connorwhite-online/junkr-obd/hardware/3d_models/ATTRIBUTION.md

# Third-Party 3D Model Attribution

## Adafruit_CAD_Parts (MIT License)

The following STEP files are vendored from Adafruit's public CAD parts
repository, used under the MIT License.

- `ads1115_pid1085.step` — Adafruit ADS1115 breakout (PID 1085)
- `qualia_esp32s3_pid5800.step` — Adafruit Qualia ESP32-S3 (PID 5800)

Source: https://github.com/adafruit/Adafruit_CAD_Parts
Copyright (c) 2016 Adafruit Industries. MIT License.

```
Permission is hereby granted, free of charge, to any person obtaining a copy
of this software and associated documentation files (the "Software"), to deal
in the Software without restriction, including without limitation the rights
to use, copy, modify, merge, publish, distribute, sublicense, and/or sell
copies of the Software, and to permit persons to whom the Software is
furnished to do so, subject to the following conditions:

The above copyright notice and this permission notice shall be included in all
copies or substantial portions of the Software.

THE SOFTWARE IS PROVIDED "AS IS", WITHOUT WARRANTY OF ANY KIND...
```

Full license text: https://github.com/adafruit/Adafruit_CAD_Parts/blob/main/LICENSE

> Other models referenced in [`../docs/3D_MODELS.md`](../docs/3D_MODELS.md)
> (TE Connectivity, McMaster-Carr, manufacturer-supplied) are **not**
> vendored here — their terms of use prohibit redistribution. Download
> them directly from the source per the instructions in that doc.
