connorwhite-online/junkr-obd/hardware/ecu_interposer/diagram/connector_diagram.pdf

## 1 Exploded view (mating axis left to right)

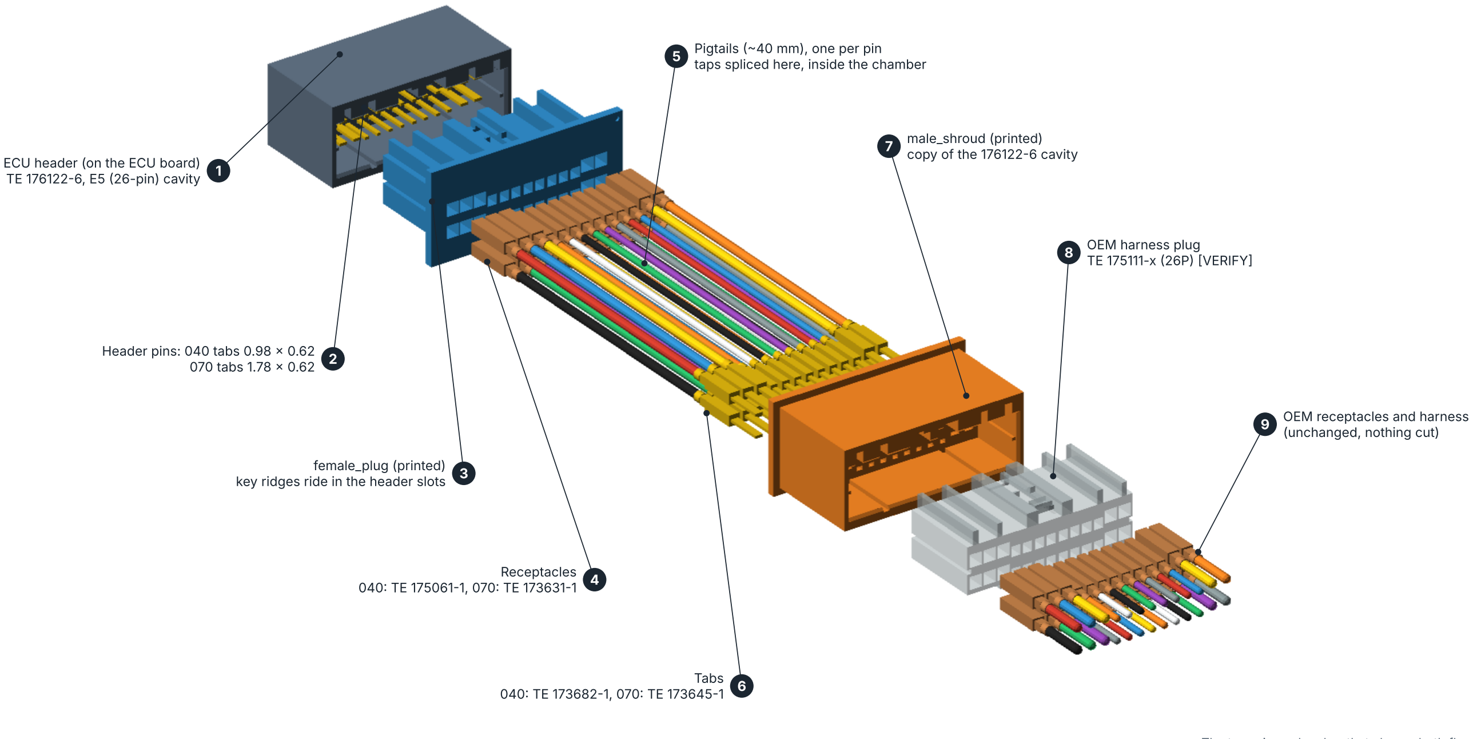
[picture p3: figure]
1 ECU header (on the ECU board) TE 176122-6, E5 (26-pin) cavity; 2 Header pins: 040 tabs 0.98 x 0.62 070 tabs 1.78 x 0.62; 3 female_plug (printed) key ridges ride in the header slots; 4 Receptacles 040: TE 175061-1, 070: TE 173631-1; 5 Pigtails (~40 mm), one per pin; taps spliced here, inside the chamber; 6 Tabs 040: TE 173682-1, 070: TE 173645-1; 7 male_shroud (printed) copy of the 176122-6 cavity; OEM harness plug TE 175111-x (26P) [VERIFY]; OEM receptacles and harness (unchanged, nothing cut)

2 Section A-A: interposer plug seated in the ECU header, cut 4 mm above the floor (pin numbers from the KZJ95 manual)
Fit in the header

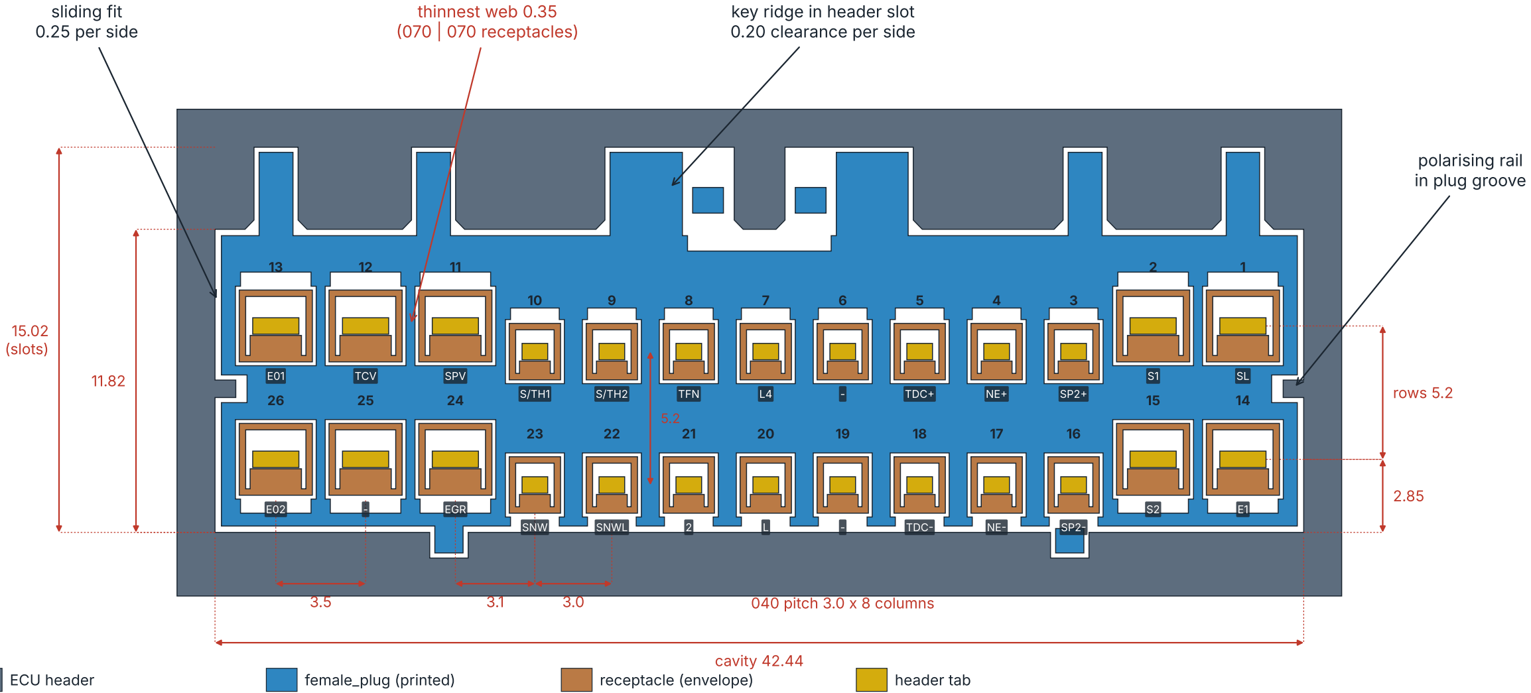
[picture p4: figure]
cavity 42.44; 040 pitch 3.0 x 8 columns; rows 5.2; 15.02 (slots); thinnest web 0.35 (070 | 070 receptacles); key ridge in header slot 0.20 clearance per side; polarising rail in plug groove; sliding fit 0.25 per side; ECU header; female_plug (printed); receptacle (envelope); header tab; TCV; SPV; EGR; SNW; SNWL; TFN; TDC+; TDC-

Plug envelope vs cavity | 41.94 x 11.32 in 42.44 x 11.82 (0.25/side)
Key ridges vs slots | 0.20/side, unique pattern per section
Insertion depth | 14.3 of 14.5 (stops 0.2 short of the floor)

Pin engagement

040 tab into receptacle | 5.89 (tab 7.09 proud - gap 0.2 - face wall 1.0)
070 tab into receptacle | 6.79 (tab 7.99 proud)
Shroud side | identical by construction (same tab heights)

Walls in the printed plug

Between columns | 070 | 070: 0.35 070 | 040: 0.37 040 | 040: 0.70
Between rows | 040: 2.70 070: 2.10
Under lower row (incl. lance) | 040: -0.10 070: +0.50
Over upper row (incl. lance) | 040: 2.82 070: 1.42

Verdict

Fits and engages as designed. Walls under 0.6 mm need resin or MJF.

Lower 040 lance reliefs break 0.1 mm through the underside: they

become open windows, which is harmless but visible.

Latch from TE's 175110-6 STEP. Still [MEASURE]: terminal body sizes.

## Analysis

070 column: pins 13 / 26 (E01 / E02)

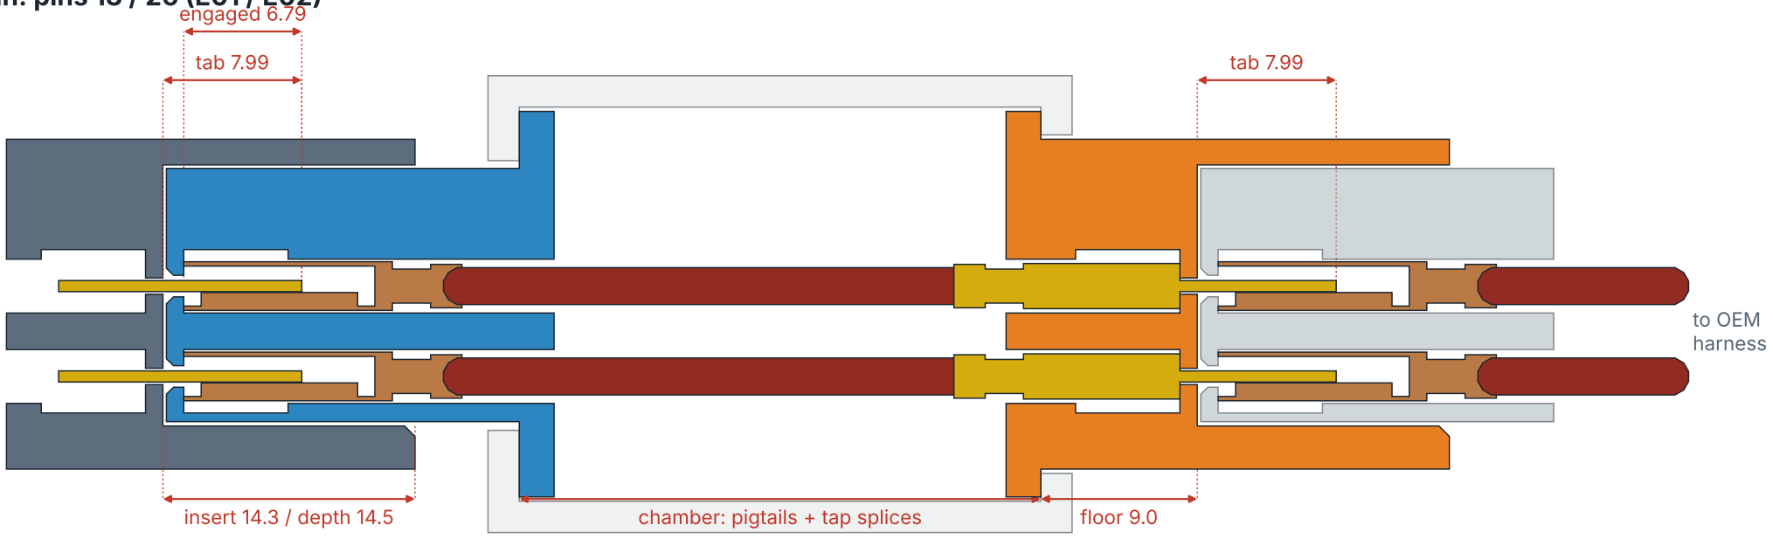
[picture p5: figure]
tab 7.99; engaged 6.79; insert 14.3 / depth 14.5; chamber: pigtails + tap splices; floor 9.0; to OEM harness

ECU
board

3 Section B-B: lengthwise through one pin column, assembled (ECU on the left, harness on the right)

040 column: pins 9 / 22 (S/TH2 / SNWL)

ECU
board

# 1KZ-TE ECU interposer: E5 (26-pin) section, exploded view and cross-section analysis

Header TE 176122-6 (geometry measured from TE's 3D model). Terminal bodies are estimates [MEASURE]; the latch is from TE's 175110-6 model. All dimensions in mm.

The two-piece chamber that clamps both flanges is hidden here; it is shown in section 3.

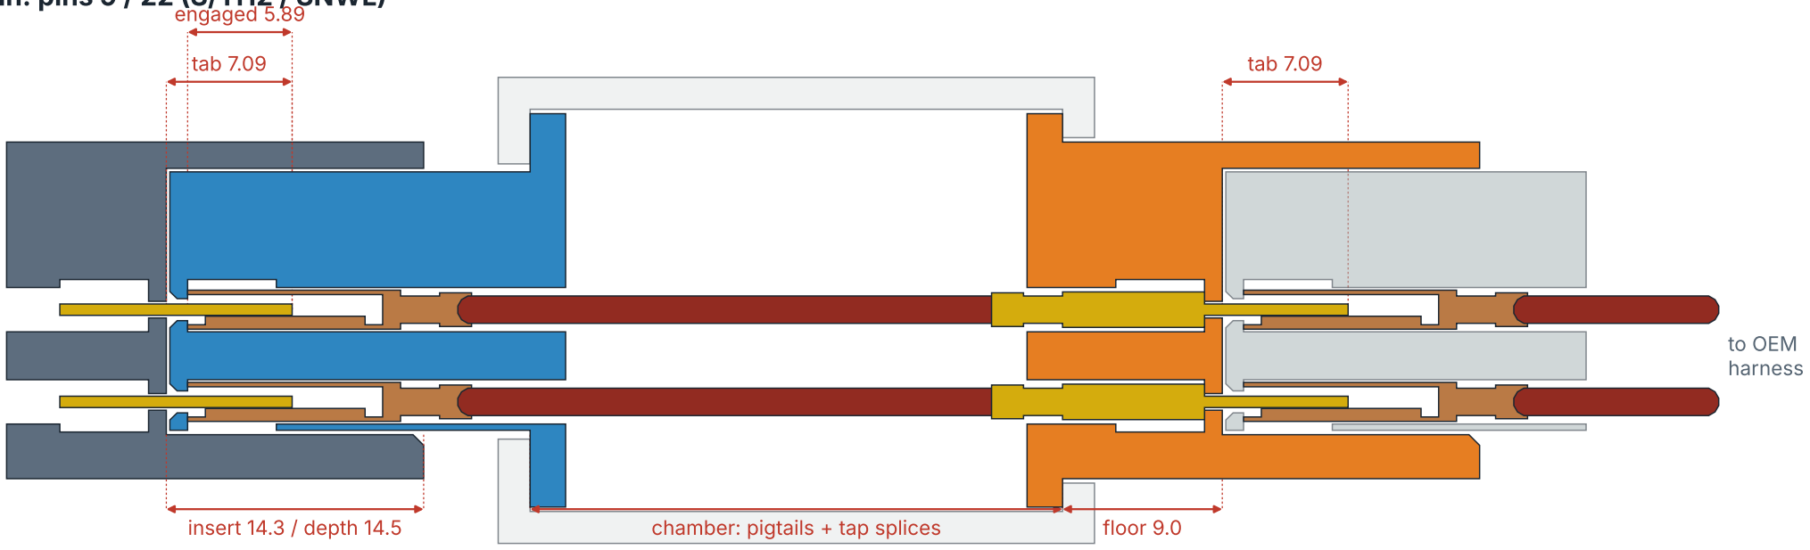
[picture p6: figure]
tab 7.09; engaged 5.89; insert 14.3 / depth 14.5; chamber: pigtails + tap splices; floor 9.0; to OEM harness

Generated by hardware/ecu_interposer/diagram/make_diagram.py from cad/diagram.scad. Sections are true scale.
