connorwhite-online/junkr-obd/docs/gauge/firmware/02_temps.png

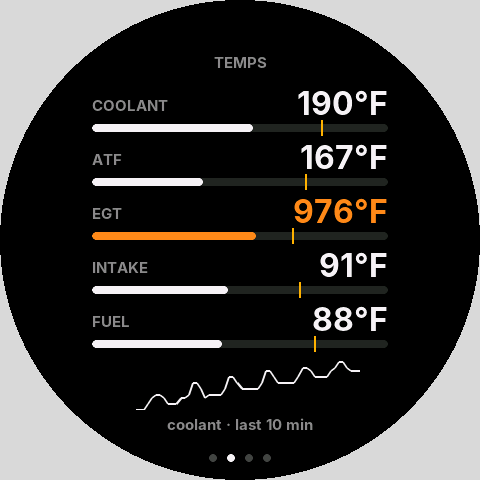
docs/gauge/firmware/02_temps.png
