connorwhite-online/junkr-obd/docs/gauge/firmware/03_engine.png

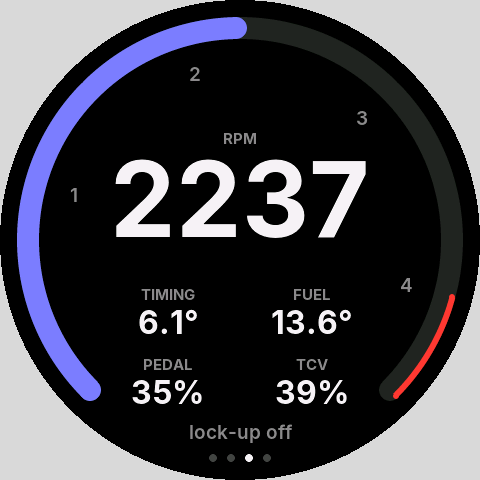
docs/gauge/firmware/03_engine.png
