connorwhite-online/junkr-obd/docs/gauge/firmware/05_alert.png

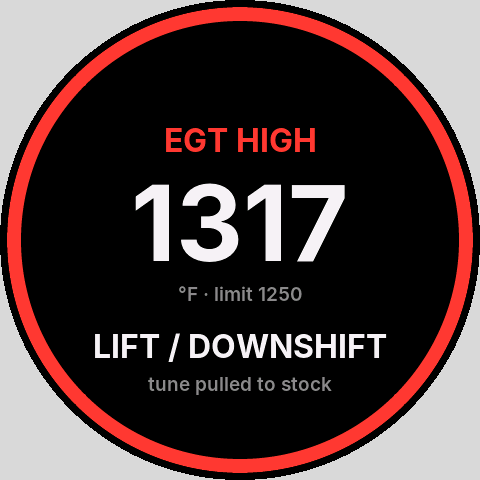
docs/gauge/firmware/05_alert.png
