connorwhite-online/junkr-obd/hardware/ecu_interposer/diagram/connector_diagram.png

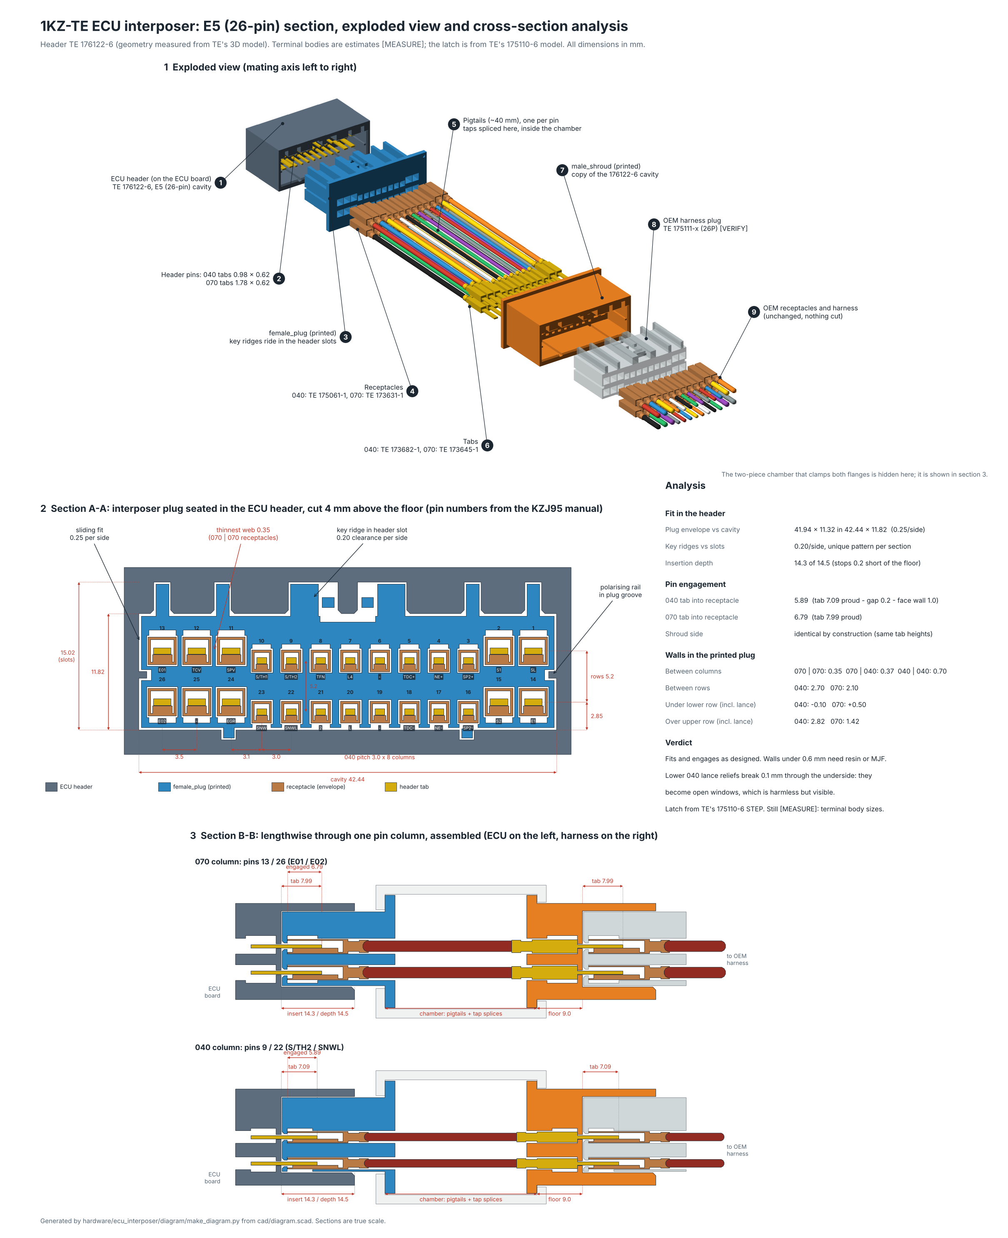
hardware/ecu_interposer/diagram/connector_diagram.png
