connorwhite-online/junkr-obd/hardware/3d_models/ads1115_pid1085.step

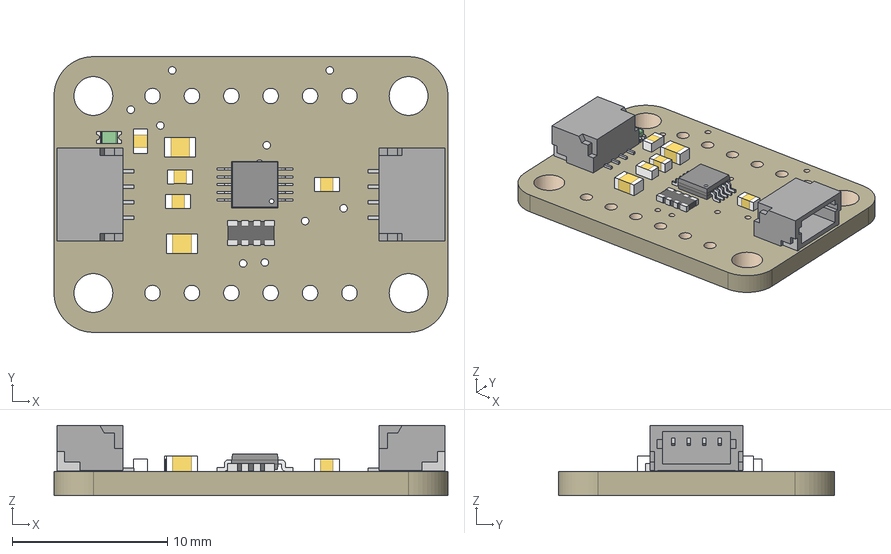
[picture p11: CAD file, 2026-05-25]
hardware/3d_models/ads1115_pid1085.step
25.4 x 17.8 x 4.53 mm
Board
ADS1015IDGST
10uF x 2
10K x 4
STEMMA_I2C_QT x 2
GREEN
10K_1
