connorwhite-online/junkr-obd/hardware/ecu_interposer/stl/tapbox_min_lid.stl

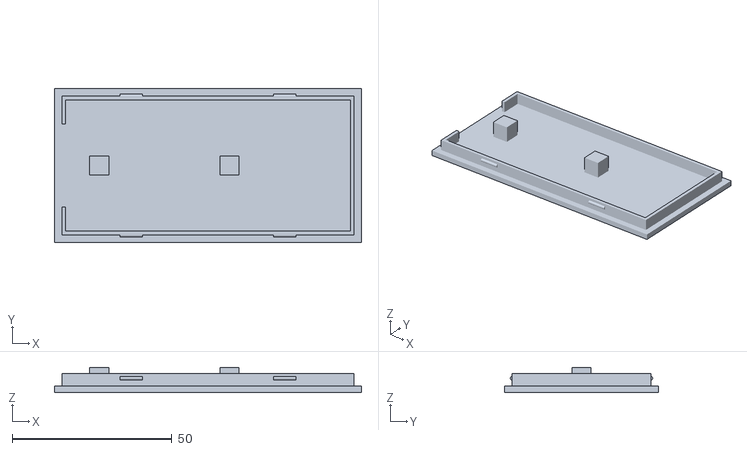
[picture p12: CAD file, 2026-11-11]
hardware/ecu_interposer/stl/tapbox_min_lid.stl
96.0 x 48.0 x 7.90
