connorwhite-online/junkr-obd/hardware/ecu_interposer/stl/tapbox_min_base.stl

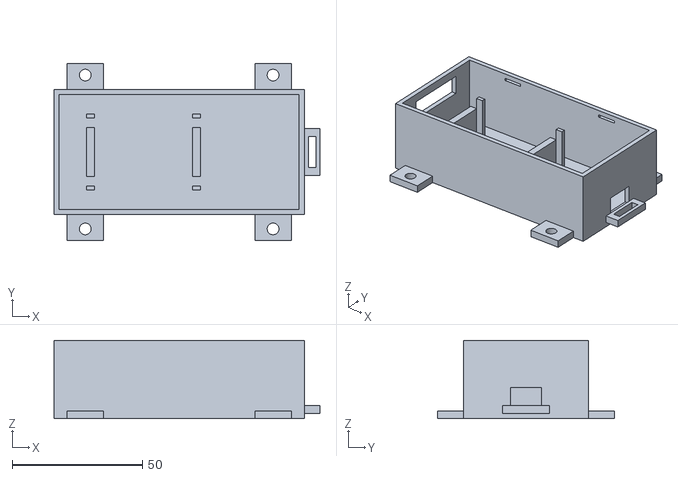
[picture p13: CAD file, 2026-11-11]
hardware/ecu_interposer/stl/tapbox_min_base.stl
102.0 x 68.0 x 30.0
