connorwhite-online/junkr-obd/hardware/ecu_interposer/stl/E5_26P_female_plug_fittest_no_latch.stl

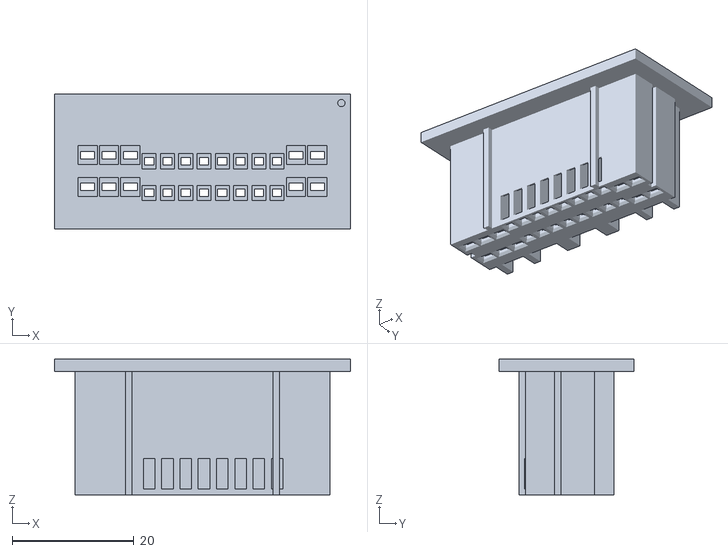
[picture p15: CAD file, 2026-10-23]
hardware/ecu_interposer/stl/E5_26P_female_plug_fittest_no_latch.stl
48.6 x 22.2 x 22.3
