connorwhite-online/junkr-obd/hardware/ecu_interposer/stl/E8_22P_female_plug.stl

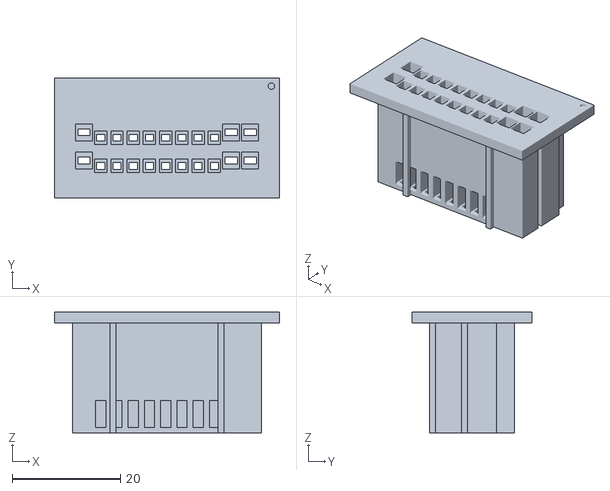
[picture p16: CAD file, 2026-10-23]
hardware/ecu_interposer/stl/E8_22P_female_plug.stl
41.6 x 22.2 x 22.3
