connorwhite-online/junkr-obd/hardware/ecu_interposer/stl/E6_16P_male_shroud.stl

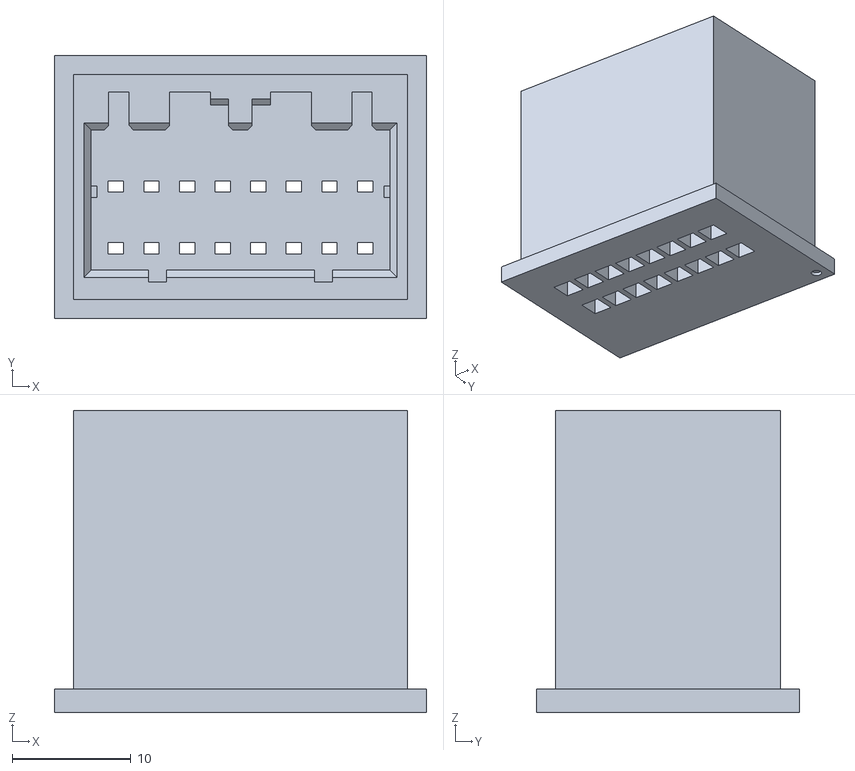
[picture p17: CAD file, 2026-10-23]
hardware/ecu_interposer/stl/E6_16P_male_shroud.stl
31.4 x 22.2 x 25.5
