connorwhite-online/junkr-obd/hardware/ecu_interposer/stl/E6_16P_female_plug.stl

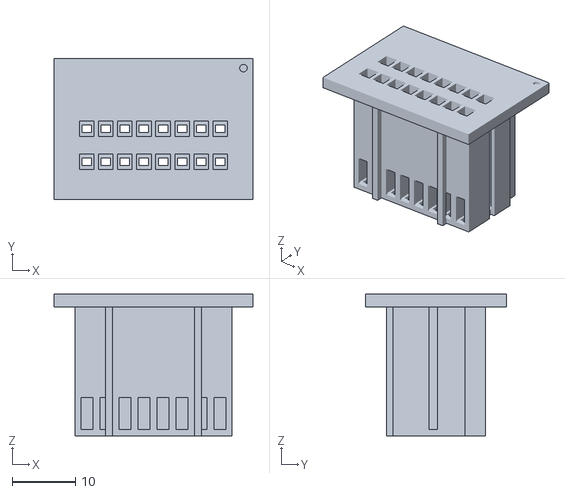
[picture p18: CAD file, 2026-10-23]
hardware/ecu_interposer/stl/E6_16P_female_plug.stl
31.4 x 22.2 x 22.3
