connorwhite-online/junkr-obd/hardware/ecu_interposer/stl/tapbox_lid.stl

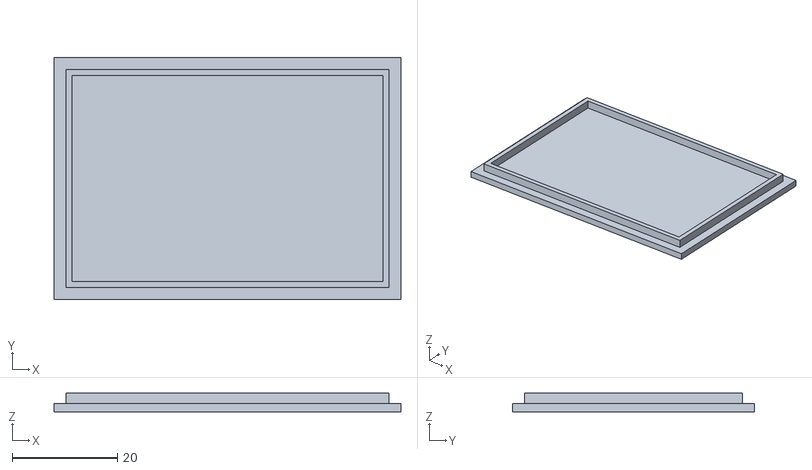
[picture p19: CAD file, 2026-10-23]
hardware/ecu_interposer/stl/tapbox_lid.stl
66.0 x 46.0 x 3.59
