connorwhite-online/junkr-obd/hardware/ecu_interposer/stl/E8_22P_male_shroud.stl

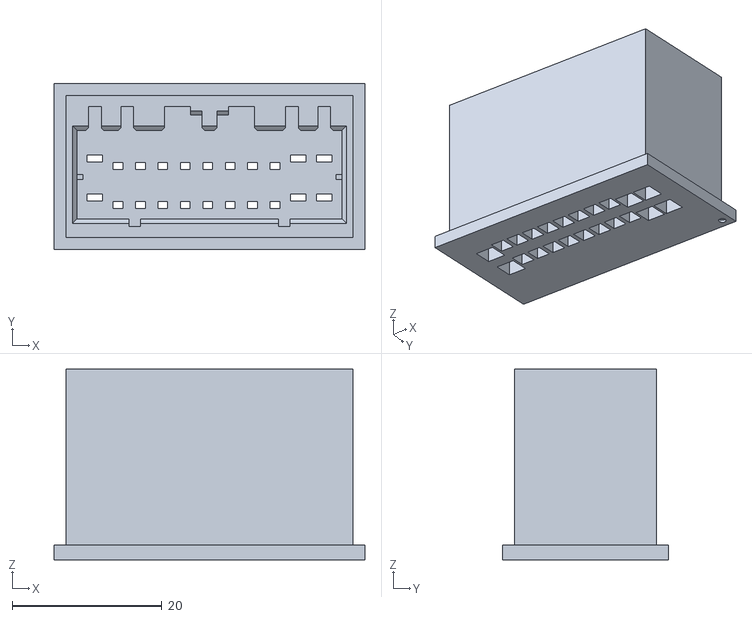
[picture p20: CAD file, 2026-10-23]
hardware/ecu_interposer/stl/E8_22P_male_shroud.stl
41.6 x 22.2 x 25.5
