connorwhite-online/junkr-obd/hardware/ecu_interposer/stl/E6_16P_chamber_top.stl

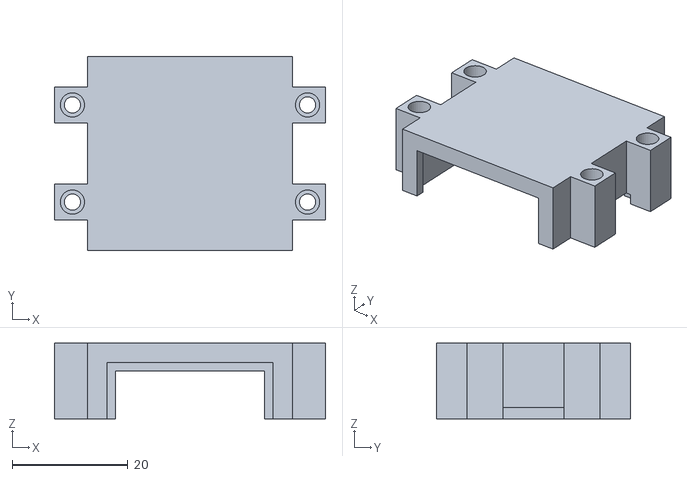
[picture p21: CAD file, 2026-10-23]
hardware/ecu_interposer/stl/E6_16P_chamber_top.stl
46.9 x 33.6 x 13.1
