connorwhite-online/junkr-obd/hardware/ecu_interposer/stl/fit_coupon.stl

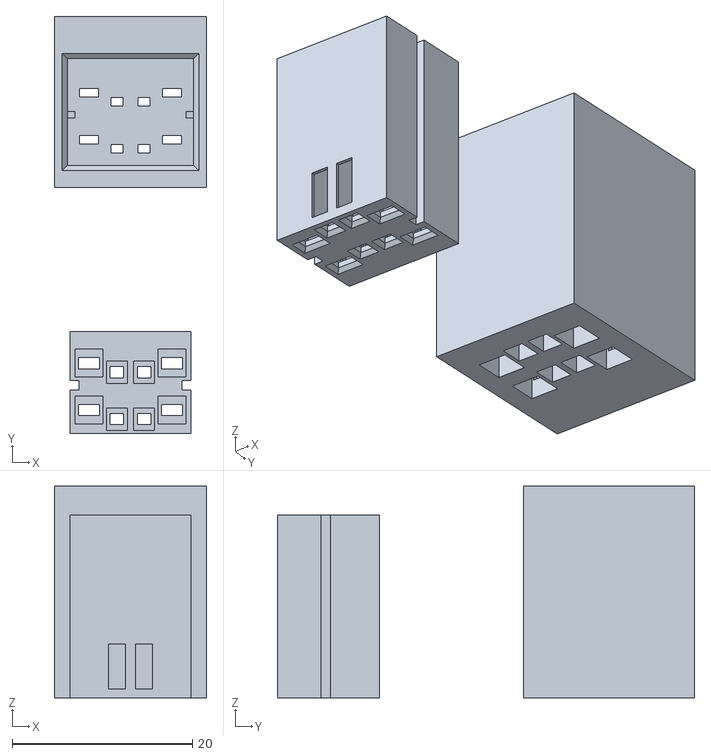
[picture p22: CAD file, 2026-10-23]
hardware/ecu_interposer/stl/fit_coupon.stl
16.9 x 46.2 x 23.5
