connorwhite-online/junkr-obd/(list of files, cad)

Other CAD files:
hardware/ecu_interposer/stl/E5_26P_female_plug.stl
