connorwhite-online/junkr-obd/docs/build-stages/renders/E6_16P_chamber_bottom.png

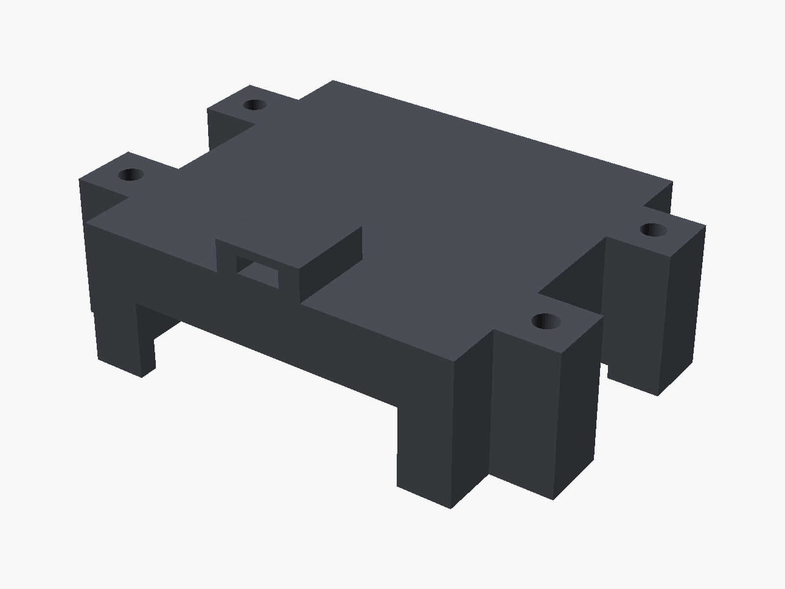
docs/build-stages/renders/E6_16P_chamber_bottom.png
