connorwhite-online/junkr-obd/docs/build-stages/renders/E6_16P_female_plug.png

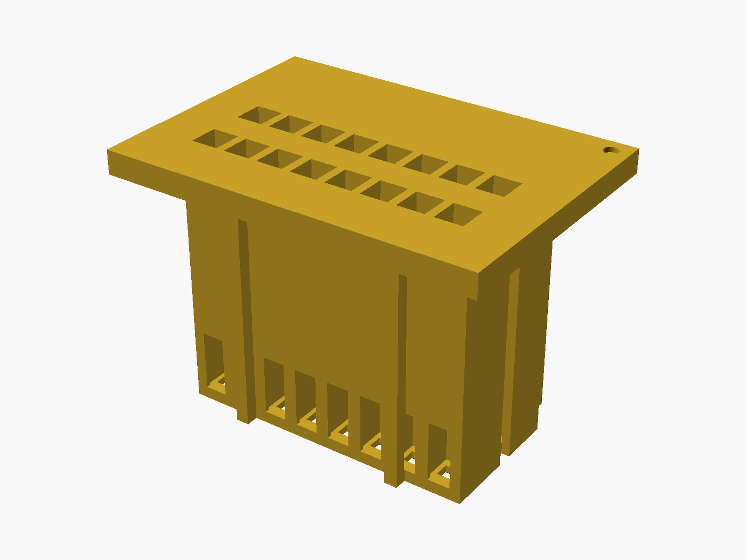
docs/build-stages/renders/E6_16P_female_plug.png
