connorwhite-online/junkr-obd/docs/build-stages/renders/E6_16P_male_shroud.png

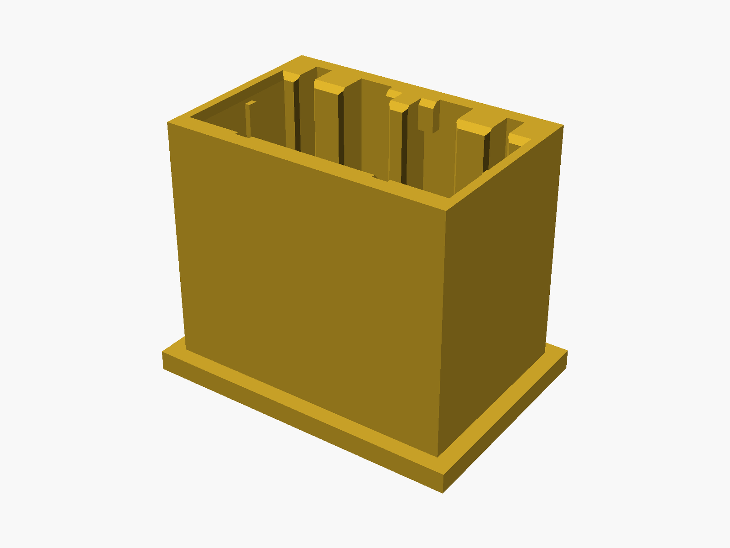
docs/build-stages/renders/E6_16P_male_shroud.png
