connorwhite-online/junkr-obd/docs/build-stages/renders/E6_exploded.png

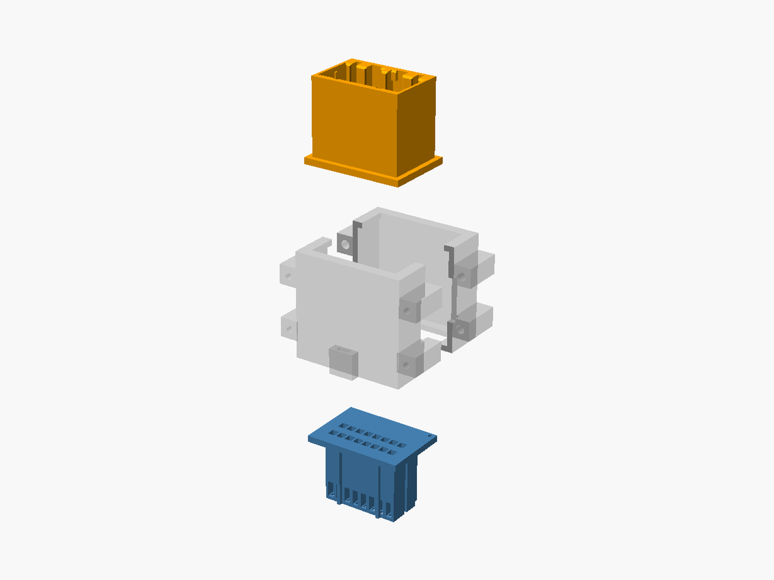
docs/build-stages/renders/E6_exploded.png
