connorwhite-online/junkr-obd/docs/build-stages/renders/E8_22P_chamber_top.png

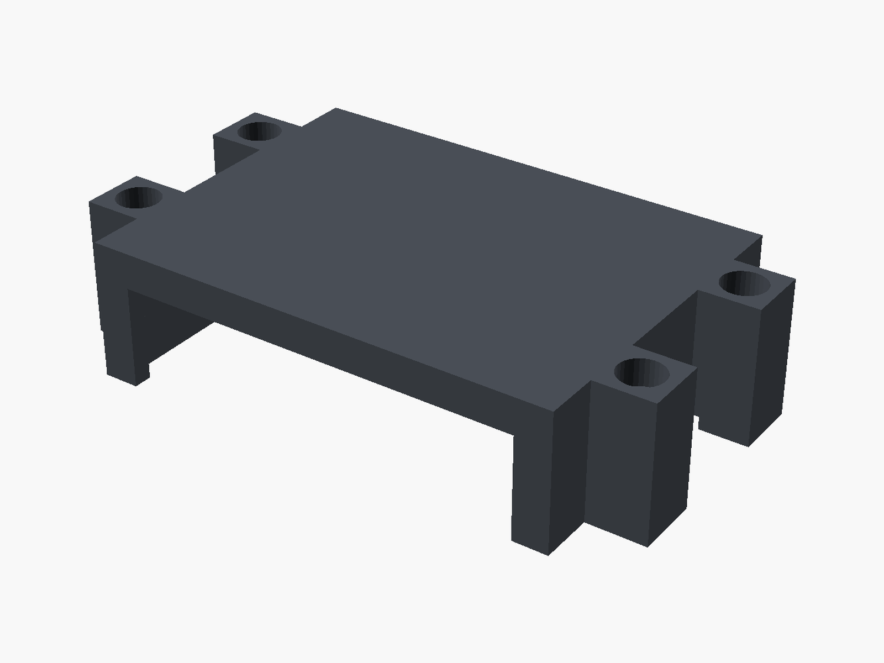
docs/build-stages/renders/E8_22P_chamber_top.png
