connorwhite-online/junkr-obd/docs/build-stages/renders/E8_22P_female_plug.png

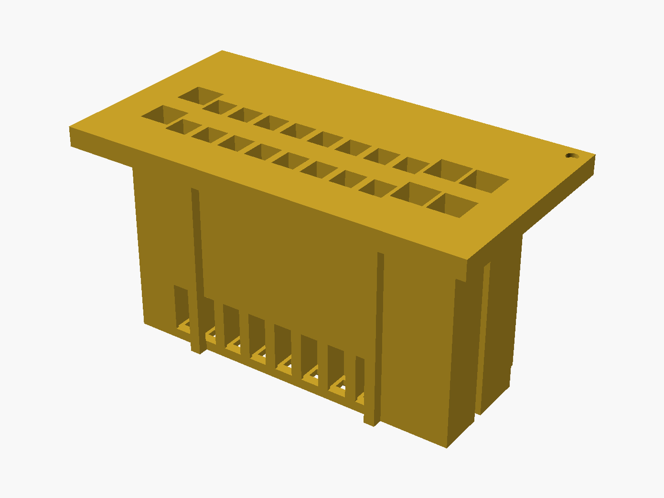
docs/build-stages/renders/E8_22P_female_plug.png
