connorwhite-online/junkr-obd/docs/build-stages/renders/E8_assembled.png

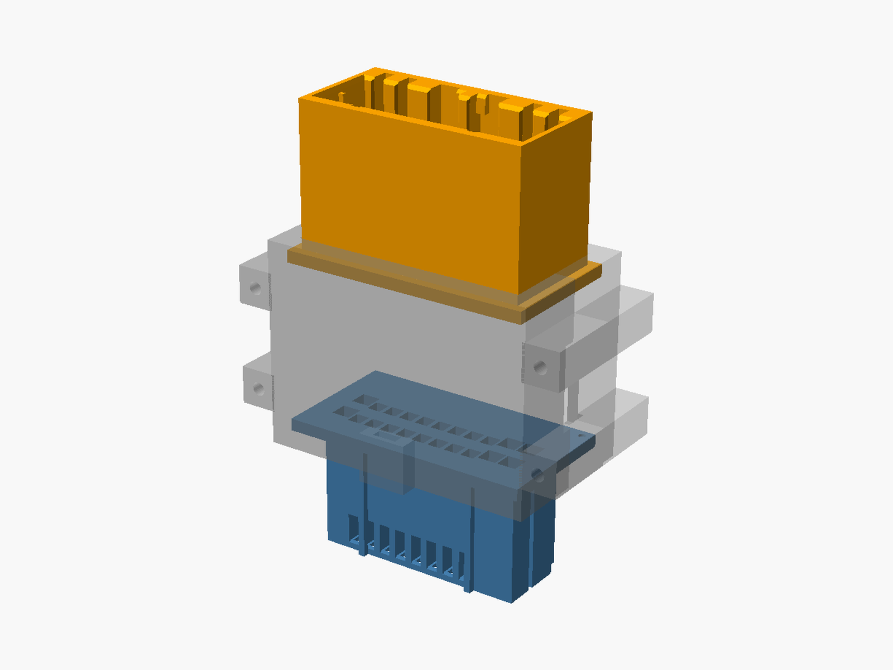
docs/build-stages/renders/E8_assembled.png
