connorwhite-online/junkr-obd/(commit log)

2025-11-07 Rescope gauge to specific engine parameters (#2)
    * Checkpoint before follow-up message
    * Refactor: Add dual IAT sensors and remove oil temp/battery voltage
    ---------
2025-11-08 Integrate display and driver for sensor value visualization (#4)
    * docs: Add guide for migrating Nextion to Adafruit TFT
    * feat: Add SquareLine Studio + LVGL display support
    This commit introduces support for SquareLine Studio and the LVGL graphics library, providing a Mac-compatible visual GUI design solution. It includes updated documentation, hardware configurations, and code examples for integrating the new display system.
    * Refactor documentation and add new guides
    * Add documentation for Adafruit 5806 displa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
2025-11-08 Update documentation for Qualia ESP32 (#5)
    * Refactor: Update docs for ESP32-S3 platform migration
    * Refactor: Update docs for platform migration
    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
2025-11-08 Consolidate sensor inputs to i2c module (#6)
    * feat: Add I2C sensor module design document
    This document outlines a new design for consolidating engine bay sensors onto a single I2C interface module, significantly reducing wiring complexity and improving installation quality.
    * feat: Add I2C sensor module option
    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
2025-11-08 Car power source investigation (#7)
    * Add automotive power guide and update wiring docs
    * Refactor: Add cigarette lighter power option for gauge install
    * Refactor cigarette lighter wiring instructions for clarity
    * Refactor power documentation for I2C sensor module
    * Refactor power distribution documentation
    * Refactor power distribution documentation for clarity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
2025-11-08 Refactor: Improve sensor selection and calibration documentation (#8)
2025-11-08 Add bench testing guide for ESP32 and I2C module (#9)
2025-11-09 Refactor: Replace direct links with search terms in BOM (#10)
2026-05-16 docs: add BOM for current Qualia ESP32-S3 simple gauge
    Reconstructs the parts list against the current source (Qualia + MAX31855 +
    ADS1115 + thermistor + MAP) instead of the pre-cleanup Mega/Nextion design.
    Uses US supplier search links (Adafruit, Digi-Key, Mouser, RockAuto, etc.)
    and flags the MAP sensor / CS pin / display size / lib_deps mismatches that
    need to be resolved before ordering.
2026-05-16 docs: switch architecture to engine-bay MCU + CAN link
    Move MAX31855 + ADS1115 sensor reads behind their own ESP32-C3 in the
    engine bay, exchange data with the cabin Qualia over a CAN bus carried on
    a 4-pin Deutsch harness (12 V, GND, CAN_H, CAN_L) instead of running raw
    SPI/I²C through automotive wiring. Updates the block diagram, harness
    pinout, ESP32-S3 pin map, and adds the engine-bay ESP32-C3 pin map and a
    firmware-layout section to README. Refreshes BOM to add the second MCU,
    CAN transceivers, 120 Ω terminations, and the 4-pin DT connector set;
    updates known issues to flag the upcoming firmware split.
2026-05-16 docs: render block / data-flow / power diagrams in Mermaid
    GitHub renders Mermaid natively in markdown — drop the ASCII art for the
    system block diagram, add a sequence diagram covering the 20 Hz read +
    CAN TX/RX loop, and a power-topology diagram showing the 12 V → buck →
    3.3 V rail in the engine bay. Also documents the proposed CAN frame
    layout (0x100 EGT, 0x101 Coolant, 0x102 MAP).
2026-05-18 firmware: split into cabin LVGL listener + engine-bay CAN publisher
    Restructures src/ into per-MCU subtrees with a shared CAN frame
    contract, and converts platformio.ini to two environments
    (cabin = Qualia ESP32-S3, engine-bay = ESP32-C3 SuperMini) selected
    via build_src_filter.
    Engine-bay firmware reads MAX31855 (SPI) and ADS1115 (I²C CH0=NTC,
    CH1=MAP) and publishes three CAN frames at 500 kbps every 50 ms.
    Cabin firmware drives an LVGL UI — a boost arc gauge across the top
    with EGT and coolant numerics below — with amber/red threshold
    shifts at warning and danger limits. UI sizes against the runtime
    display resolution so it scales to whichever Qualia panel variant
    the board ships wit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
2026-05-18 kicad: hardware specs for engine-bay + cabin shields
    Adds canonical schematic netlists, BOMs with KiCad symbol + footprint
    references, design rules (trace widths, clearances, layer stack), and
    placement/routing notes for the two PCBs.
    Engine-bay shield: ESP32-C3 SuperMini + MAX31855 + ADS1115 + TJA1051
    all on 0.1" sockets, dual buck rails (3.3 V for digital, 5 V for the
    MAP sensor), SMBJ24A TVS + polyfuse + reverse-polarity diode on the
    12 V input, 2:1 voltage divider on the MAP signal so the ADS1115 stays
    inside its 3.3 V safe range, NTC divider matching the firmware's
    Steinhart formula, 120 Ω termination on a jumper, Deutsch DT04-4P in.
    Cabin shield: small breakout for the Qualia carryi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
    [bom.csv]
2026-05-18 docs: bench testing guide + opt-in serial debug for engine-bay
    Walks the build up in seven stages — compile, cabin UI alone, engine-bay
    reads alone, CAN loopback, real sensors, MAP sensor calibration check,
    then PCB fab — so PCBs only get ordered after every architectural
    assumption has been validated on the bench.
    Adds a DEBUG_PRINTS build flag and a paired engine-bay-debug PIO env
    that prints sensor values to the serial monitor once per second; lets
    Stage 3 verify the read path without needing a CAN transceiver to be
    wired up yet.
    Includes Mermaid wiring diagrams for stages 3, 4, and 5 and an explicit
    wiring table for each sensor breakout, with pass criteria and common
    failure-mode f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
    [main.cpp]
2026-05-18 docs: bench testing BOM
    Splits the bench-rig shopping list out of BENCH_TESTING.md into a
    dedicated docs/BENCH_BOM.md with US supplier search links and rough
    costs. Organized into product-BOM parts you'll already have, bench-only
    essentials, and optional debugging gear (logic analyzer, CAN sniffer,
    bench supply) with notes on when each one actually pays off.
    Approximate bench-only total: $150-300 depending on what's already
    on the bench. Bring-up does not require the optional debugging gear
    unless something goes wrong in Stage 3 or 4.
2026-05-20 hardware: vendor Adafruit STEP models + 3D sourcing guide
    Adds the MIT-licensed Qualia ESP32-S3 (PID 5800) and ADS1115 (PID 1085)
    STEP files from Adafruit's public CAD parts repo into
    hardware/3d_models/, with attribution. The Qualia model is the one you
    build the cabin display bezel around.
    Adds docs/3D_MODELS.md: a per-BOM-item sourcing table covering which
    models are vendored here, which to download from TE / GrabCAD / SnapEDA
    / manufacturer sites (TE and McMaster block automated access and forbid
    redistribution, so those stay external), and which footprints KiCad
    already ships so they fall out of the board STEP export for free. Leads
    with the recommended workflow — export the populate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
    [ads1115_pid1085.step]
2026-05-20 docs: pin exact ESP32-C3 SuperMini 3D model download links
    Located a matching STEP for the SuperMini board (GrabCAD model by Ulf
    Hille, also packaged in the mrtnvgr/KiCad_ESP32-C3-SuperMini repo).
    Recording the direct links rather than vendoring the file: the GitHub
    repo carries no license and the model derives from a GrabCAD upload
    whose Community License prohibits redistribution. Free to download
    directly.
2026-10-22 hardware: 1KZ-TE ECU interposer research + parametric printable housing
    - docs/ECU_INTERPOSER_RESEARCH.md: KZJ95 1KZ-TE (ECD-V3) ECU connectors
    (A22/B16/C26, TE Multilock 176122-6 family), pinout, and an honest
    observe-vs-change analysis for a passive interposer
    - docs/ECU_TAP_ARCHITECTURE.md: ESP32-S3 tap board, signal conditioning
    per tap class, logging + CAN integration
    - hardware/ecu_interposer: OpenSCAD parametric female plug / male shroud /
    chamber / tap box, fit coupon, exported STLs
    Claude-Session: https://claude.ai/code/session_014TUkWiJiSXC5o9yoCh6WK9
2026-10-22 Model the interposer on the measured TE 176122-6 header
    Rebuild the CAD around the real ECU header geometry (measured from TE's
    3D model via rusEFI): per-section cavity lengths, 040/070 column layout at
    3.0/3.5 mm pitch, 5.2 mm rows, top-wall key slots and end-wall rails.
    The fit coupon is now a 4-column slice at the real pitch, chamber halves
    export split face down, and the docs list the TE plug, terminal and crimp
    tool part numbers.
    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
2026-10-22 Add the learning tuner, firmware lookup and tests
    tuner/ learns PIM and coolant-temp correction tables over baro x intake
    temp x rpm x pedal using dithered safe extremum seeking, with authority
    scaled to the fitted sensor modules and a structural lambda ratio cap.
    src/tap/piggyback.h is the firmware lookup and real-time caps, exported
    tables go to src/tap/tables_gen.h, and a host test checks the C++ against
    the Python version. docs/LEARNING_TUNER.md covers the method, safety,
    simulator results and limits.
    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
2026-10-22 Add an exploded diagram and cross-section analysis of the C26 section
    cad/diagram.scad models the terminals and pigtails and emits exploded or
    cut views; diagram/make_diagram.py renders the exploded view with
    callouts, true-scale transverse and lengthwise sections with dimensions,
    and a table of fits, pin engagement and wall thicknesses.
    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
2026-10-22 Use the KZJ95 wiring manual (EWD269F) for the ECU pinout
    Replace the KZN130-derived pinout with the automatic (Engine and ECT ECU)
    pinout from the 1996 Land Cruiser Prado EWD, pages 206-210 and 220-223,
    also saved as pinout_kzj95_at.csv. Rename the sections to the manual's
    connector codes (E5 26-pin, E6 16-pin, E8 22-pin; the KZN130 letters were
    swapped), add Toyota pin numbering to the CAD, put the pin-1 markers on
    the real pin-1 corner, and label pins in the cross-section diagram.
    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
2026-10-22 Interposer: model the Multilock latch from TE's 175110-6 STEP
    - male_shroud: lock bar at the mouth for the OEM plug's hooks, floor key
    grooves and slot-edge chamfers (found by test-fitting TE's STEP: zero
    interference when seated, hook lock face 0.15 mm behind the bar)
    - female_plug: own lock tines with 45-degree hooks and a press tab, body
    relief under the tines, bottom keys for the floor grooves
    - sections.scad: floor groove positions per section
    - research doc 2.1a, README, previews and connector diagram updated
    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
2026-10-23 Interposer: tine-free fit-test plugs for trying in the ECU header
    latch_tines=false drops the lock tines (key ridges stay cut back so the
    plug still clears the header's lock bar). export_all.sh writes
    E*_female_plug_fittest_no_latch.stl; nothing can snap off inside the ECU.
    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
2026-10-24 Add ECU tap board schematic, BOM and notes; fix tap front ends
    kicad/tap/ gets the net-by-net schematic, BOM and layout notes for the
    ESP32-S3 tap board, plus frontend_check.py, which checks every divider
    against the 47 kOhm splice resistor.
    Fixes found while drawing the board:
    - Two MCP3208s with a REF3030 3.0 V reference (11 channels plus the
    Phase 2 readbacks; 4.096 V cannot work with VDD 3.3 V).
    - The DIG/CAP/CAP-HV front ends now account for the 47k at the splice
    (the old CAP-HV divider never reached the Schmitt threshold).
    - BATT is no longer tapped: it is live key-off and would back-feed.
    - 500 mA PTC at the +B splice, 1 A buck, E01 power return, E2 analog ref.
    - Phase 2 dead-man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
2026-10-24 Plan added sensors, round gauge screens and log channels
    EGT probe and 3-bar MAP picks with mounting and engine-bay node impact,
    extended CAN IDs, five gauge screen mockups, and the log channel and
    event list.
    Claude-Session: https://claude.ai/code/session_015K37fEp7Y9JjQBxpKuo9fy
2026-10-25 Firmware: round gauge on the Qualia, 3-bar MAP node, full CAN protocol
    Brings the firmware up to the merged sensors/gauge plan so the bench
    milestone (log first, gauge on the bench) can start.
    - shared/can_protocol.h: every planned frame (0x100-0x115) with pack and
    unpack helpers; 0x101 coolant retired.
    - Engine-bay node: coolant NTC dropped, GM 3-bar absolute MAP read
    ratiometrically against a new +5 V monitor (A3), baro latched at key-on
    and refreshed while the tap reports rpm 0, new 0x103 frame. Schematic
    and BOM gain the A2/A3 dividers and a spare J4 sender input.
    - Gauge: Qualia RGB panel (TL021WVC02 2.1" round) via Arduino_GFX + LVGL,
    Drive/Temps/Engine/Tune pages and the al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
2026-10-25 Gauge: simplify the Drive page to one boost arc and three readouts
    Per Connor: one big 270-degree arc for real boost (stock sensor, not what
    the ECU is told), with EGT, intake and coolant as icon + number
    underneath. The ECU-sees view stays on the Tune page. Adds a 28 px digit
    font and a three-glyph Material Icons Round font; renders regenerated.
    Claude-Session: https://claude.ai/code/session_0118bCHXcquEU65toAkFC2gS
2026-10-26 Add three-stage build plan with a BOM per stage
    Claude-Session: https://claude.ai/code/session_011oMNVTct9jRVEARaE44XNT
2026-10-26 Build stages: cut to pictures and clickable parts lists
    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
2026-10-26 Build stages: simple off-the-shelf stage 1, custom tap board moves to a later upgrade
    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
2026-10-26 Build stages: minimal stage 1, every input is two resistors
    Stage 1 drops to an ESP32-S3 DevKitC, resistor dividers and the E6/E8
    interposers (terminals back in the parts list). Software replaces the
    ADCs, optocouplers, SD logger, baro sensor, CAN parts and buck converter.
    Gauge and engine-bay node move to ESP-NOW. Adds wiring and tap box sheets,
    and moves the images out of the git-ignored docs/build folder.
    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
2026-11-11 Stage 1 on Materialize: minimal DevKitC tap box, build guide, MCP process
    - cad/tapbox_min.scad + STLs: 96x48x30 box for one ESP32-S3-DevKitC-1
    (KZI-121), board pins-down on two saddles, snap lid with hold-down fingers
    - docs/STAGE1_BUILD_GUIDE.md: materials per printed part, full BOM, pin map,
    build and install steps
    - docs/MATERIALIZE_MCP.md: the upload/check/quote/project steps used, with
    file and material IDs and the 2026-11-11 quote
    Claude-Session: https://claude.ai/code/session_01HFwANWMmJBGrDktVvpdDmD
2026-11-12 Add part and assembly renders used on the Materialize page
    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
